lose-gravity/cat-emotion-system/enclosure/亚克力方案/工程图/back_panel.pdf

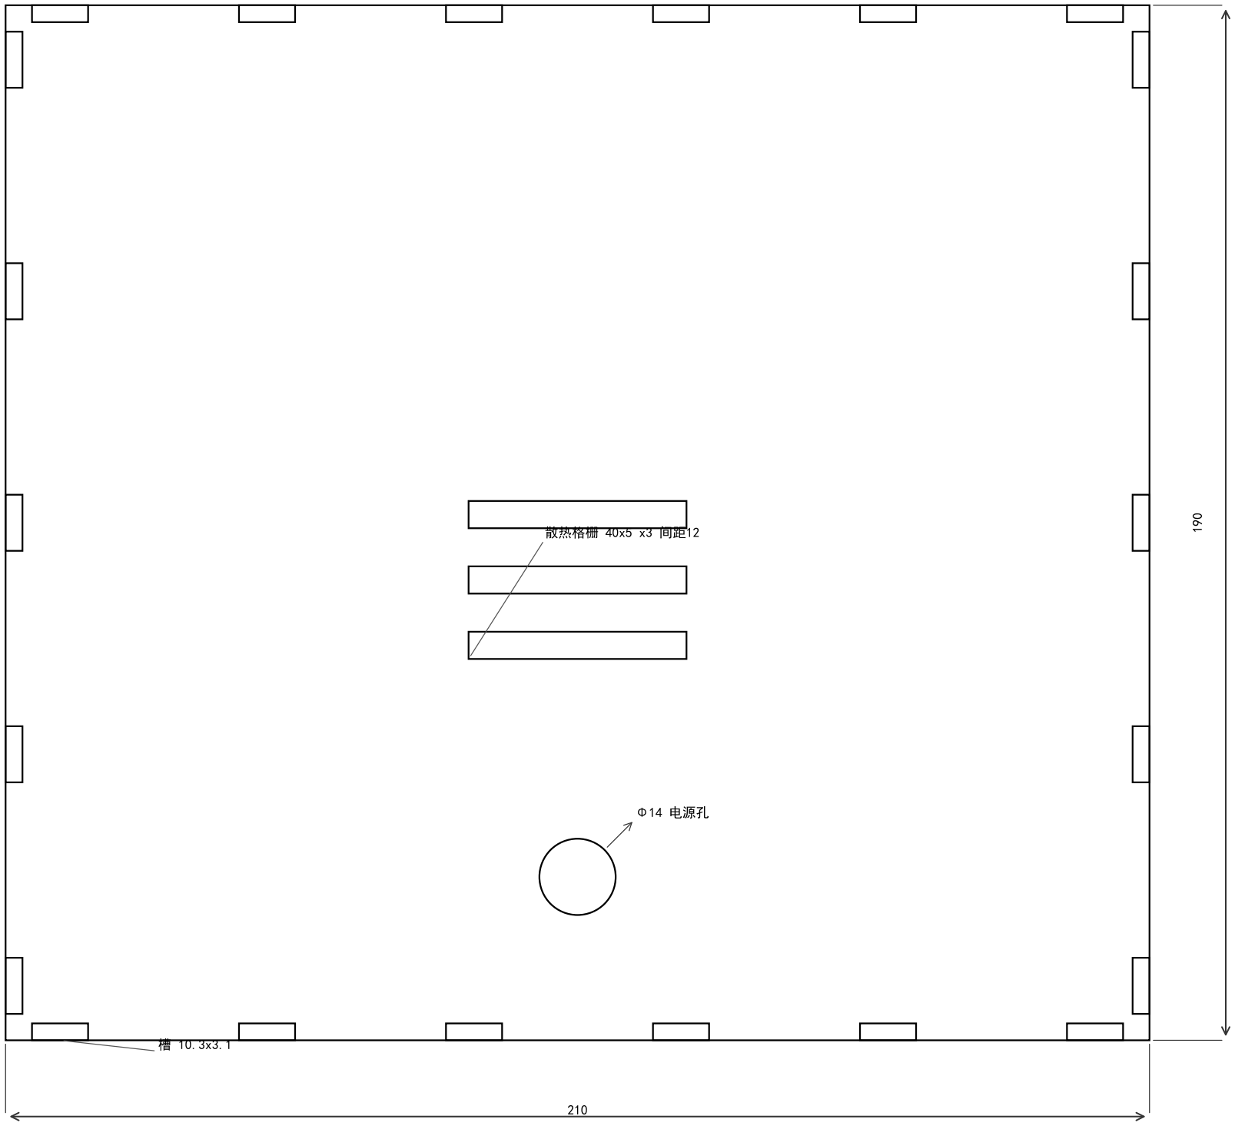
[picture p7: figure]
Φ14 电源孔; 散热格栅 40x5 x3 间距12

背板 | 白色亚克力 3mm | 1件 | 1:1 | mm
