lose-gravity/cat-emotion-system/enclosure/亚克力方案/工程图/bottom_panel.pdf

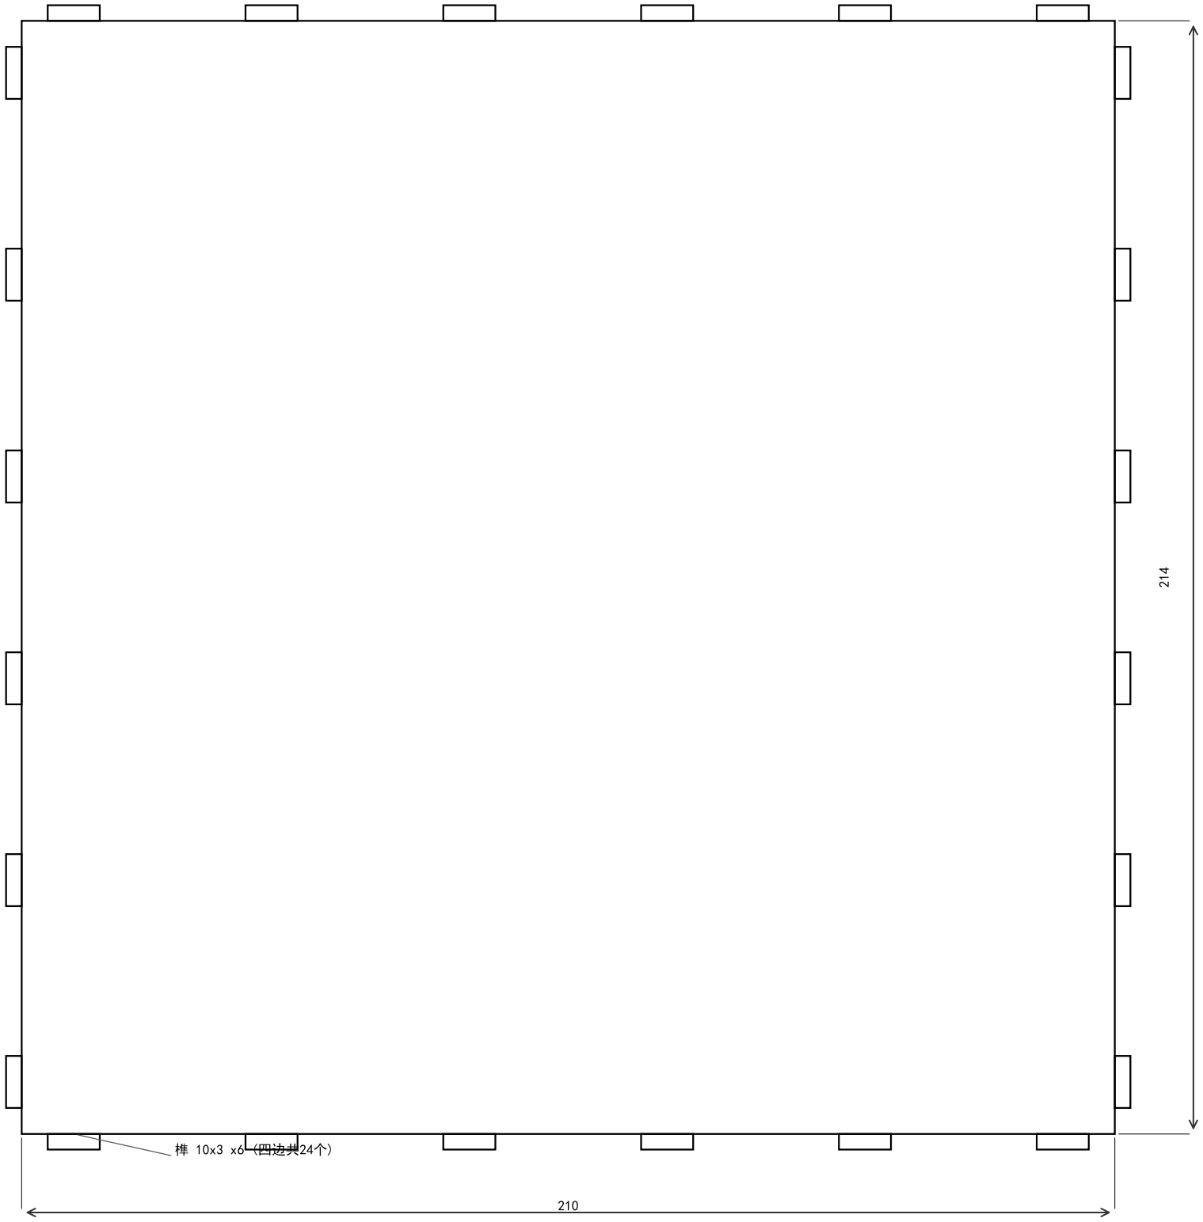
[picture p8: figure]
榫 10x3 x6 (四边共24个)

底板 | 白色亚克力 3mm | 1件 | 1:1 | mm

图面比例 1:1.1
