lose-gravity/cat-emotion-system/enclosure/亚克力方案/工程图/dispenser_vane.pdf

出粮拨片 | 白色亚克力 3mm | 1件 | 1:1 | mm

Φ5 轴孔

叶片 18x4 x3 毂Φ12
