lose-gravity/cat-emotion-system/enclosure/亚克力方案/工程图/hopper_bottom.pdf

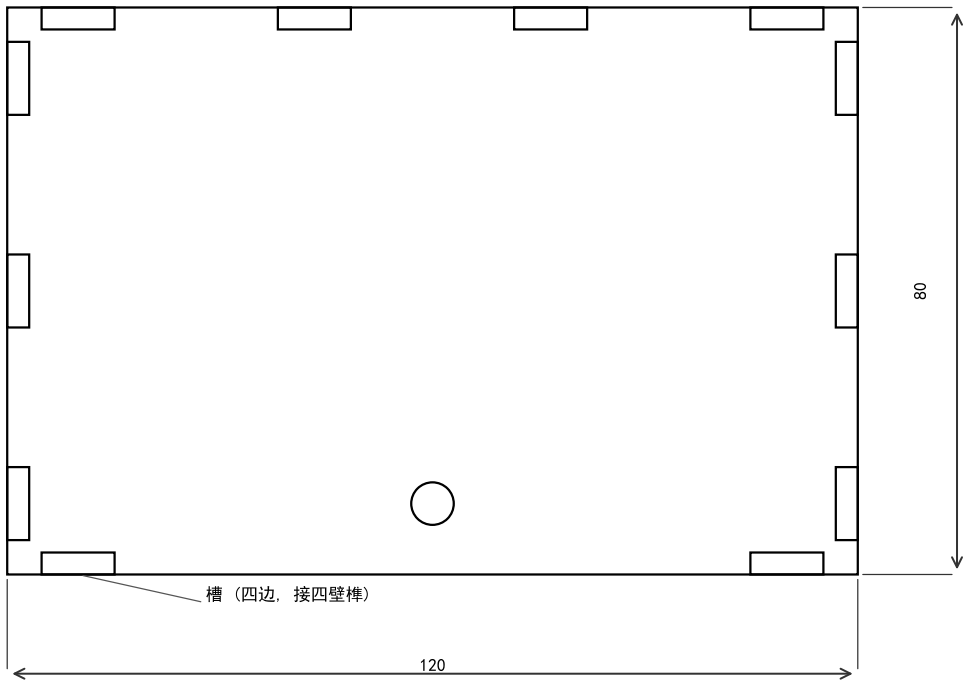
[picture p10: figure]
槽 (四边, 接四壁榫)

料仓底板 | 白色亚克力 3mm | 1件 | 1:1 | mm
