lose-gravity/cat-emotion-system/enclosure/亚克力方案/工程图/hopper_front.pdf

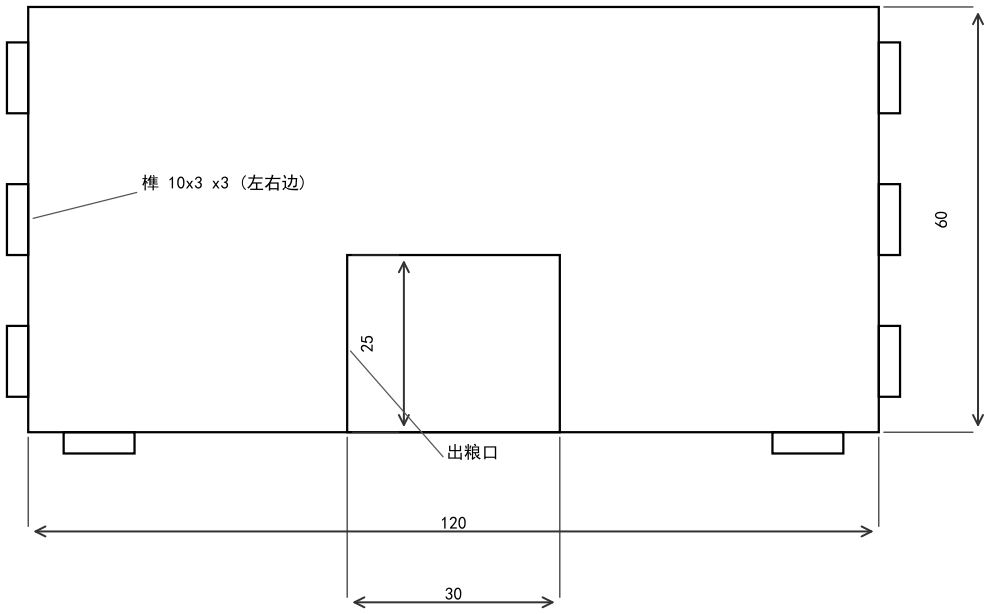
[picture p11: figure]
出粮口; 榫 10x3 x3 (左右边)

料仓前脸 | 白色亚克力 3mm | 1件 | 1:1 | mm
