lose-gravity/cat-emotion-system/enclosure/亚克力方案/工程图/hopper_left.pdf

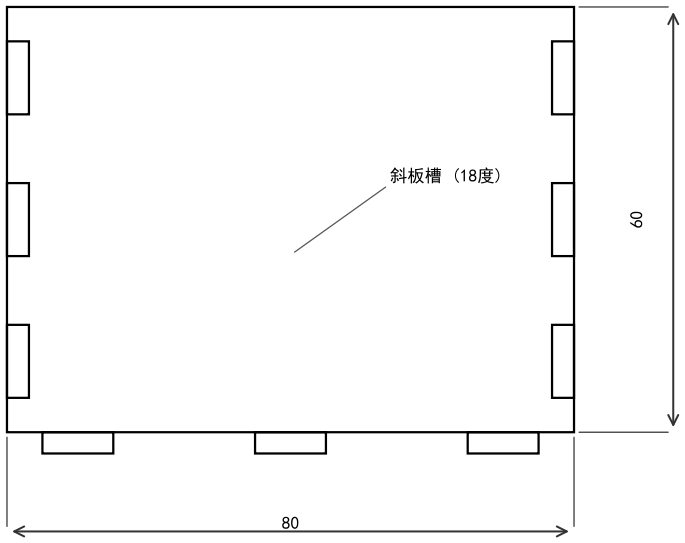
[picture p12: figure]
斜板槽 (18度)

料仓左片 | 白色亚克力 3mm | 1件 | 1:1 | mm
