lose-gravity/cat-emotion-system/enclosure/亚克力方案/工程图/hopper_right.pdf

斜板槽 (18度)

料仓右片 | 白色亚克力 3mm | 1件 | 1:1 | mm
