lose-gravity/cat-emotion-system/enclosure/亚克力方案/工程图/module_plate.pdf

元件安装板 | 白色亚克力 3mm | 1件 | 1:1 | mm

50

25

2xΦ3 功放安装孔
