lose-gravity/cat-emotion-system/enclosure/亚克力方案/工程图/servo_base.pdf

舵机座底板 | 白色亚克力 3mm | 1件 | 1:1 | mm

35

22.2

2xΦ2.5 固定孔

侧壁槽 10.3x3.1 x4
