lose-gravity/cat-emotion-system/enclosure/亚克力方案/工程图/servo_wall.pdf

舵机座侧壁 | 白色亚克力 3mm | 2件 | 1:1 | mm

35

36

2xΦ2.2 舵机夹紧孔
