lose-gravity/cat-emotion-system/enclosure/亚克力方案/工程图/side_panel.pdf

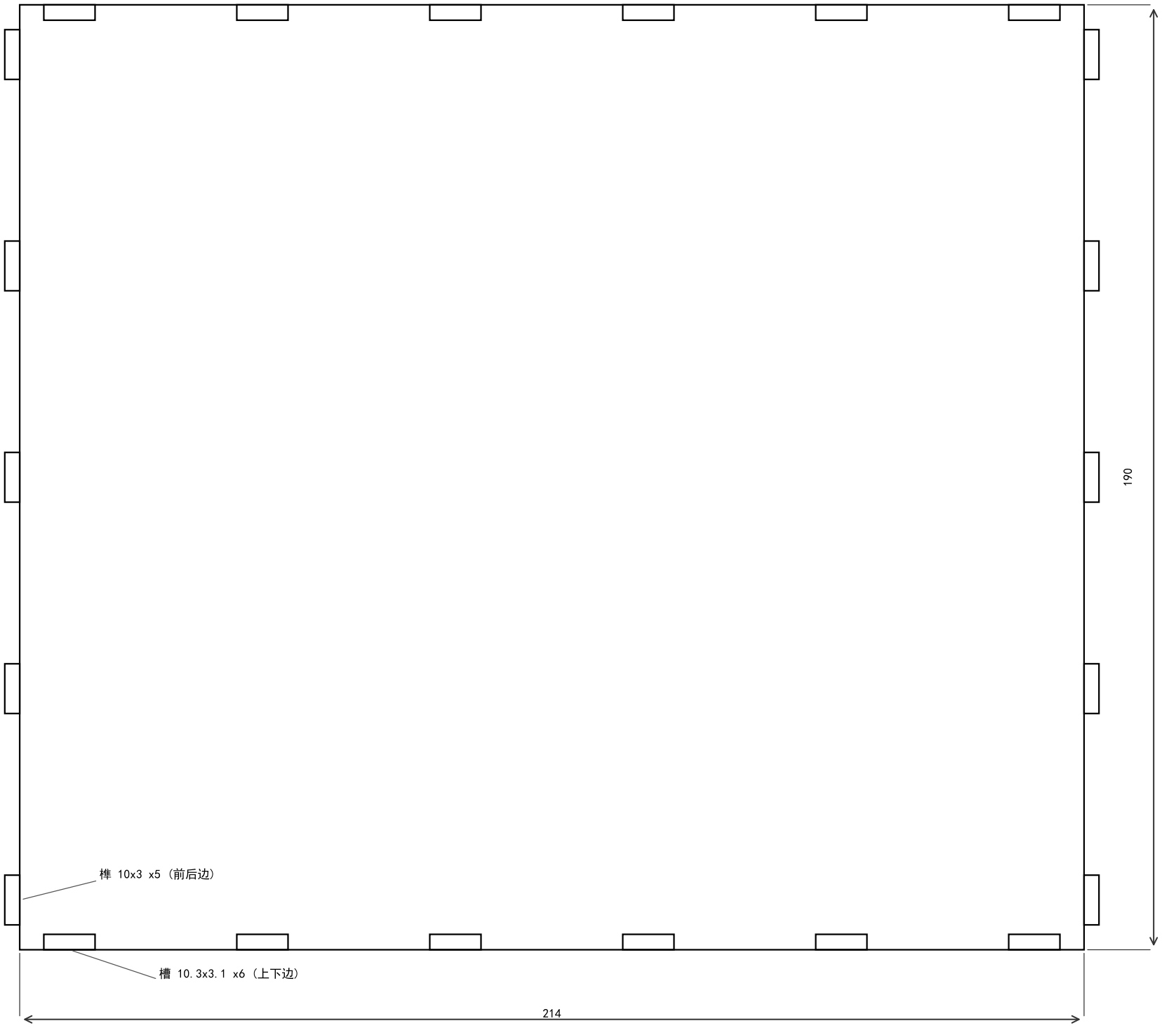
[picture p13: figure]
榫 10x3 x5 (前后边); 槽 10.3x3.1 x6 (上下边)

侧板 | 白色亚克力 3mm | 2件 | 1:1 | mm
