lose-gravity/cat-emotion-system/enclosure/亚克力方案/工程图/top_panel.pdf

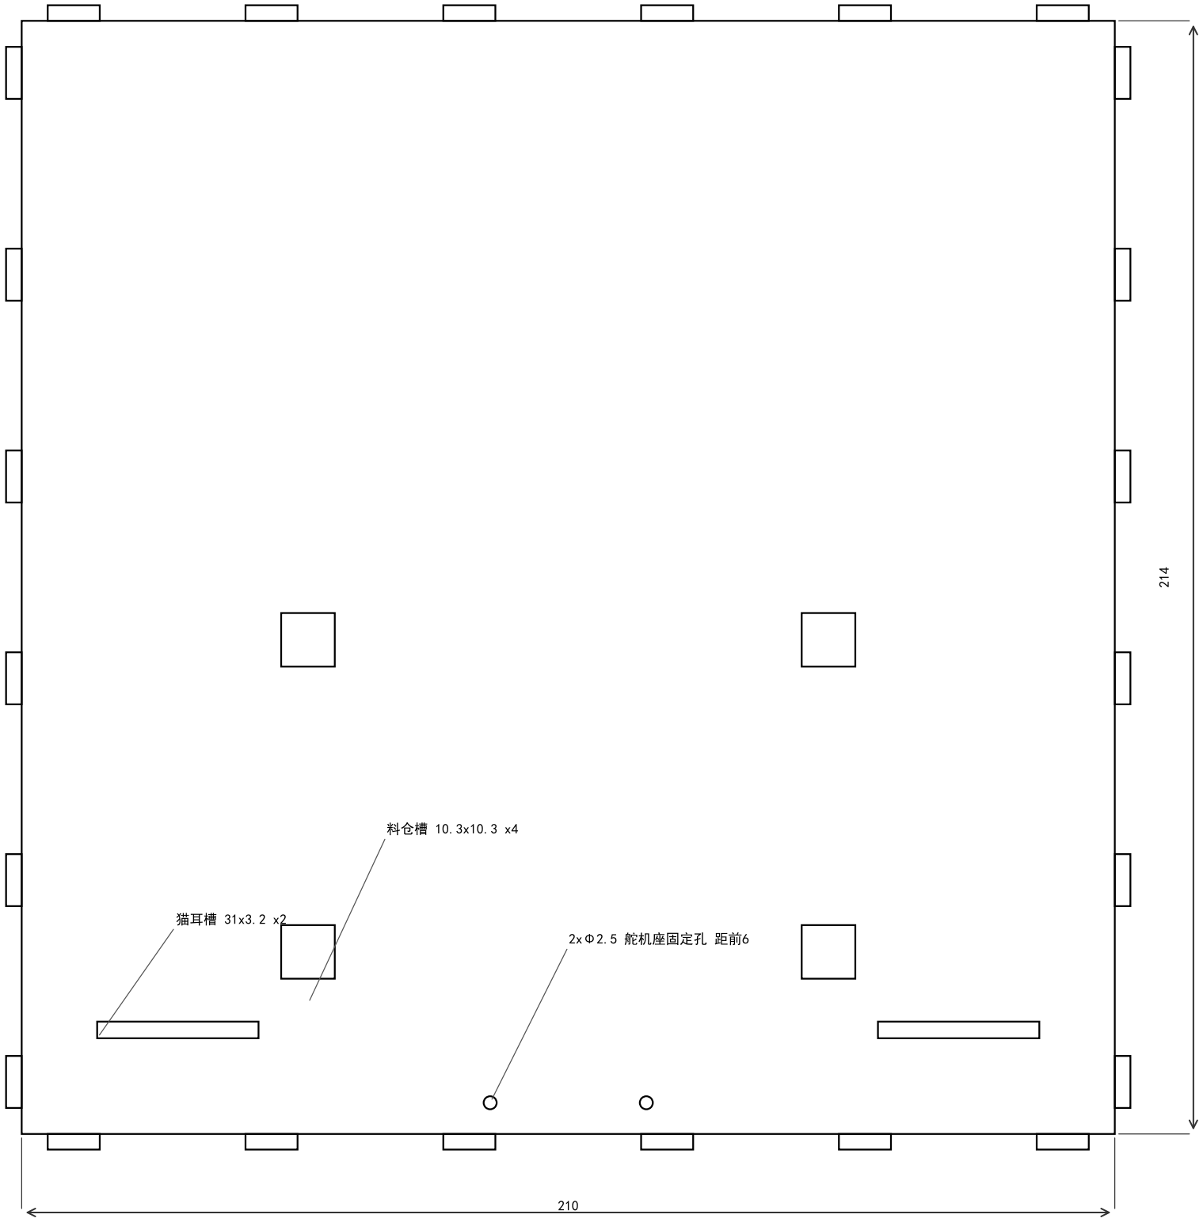
[picture p14: figure]
2xΦ2.5 舵机座固定孔 距前6; 猫耳槽 31x3.2 x2; 料仓槽 10.3x10.3 x4

顶板 | 白色亚克力 3mm | 1件 | 1:1 | mm

图面比例 1:1.1
