lose-gravity/cat-emotion-system/training/改进算法/改进报告.md

# 猫情绪识别算法改进报告（2026-10-20）

算法岗代码在本机（librosa 1.0.0 + sklearn 1.9）全流程复现后，发现并修复了三个问题，并产出了一套 HLS 友好的新交付物。原模型文件未动，本目录（04-改进算法/）全部为新增。

## 一、发现的问题

### 1. 数据泄露导致指标虚高
原训练脚本（[训练脚本.py](../01-训练代码/训练脚本.py)）**先对饥饿类做数据增强、再划分训练/测试集**——增强变体会同时出现在两边。且原验证脚本对全量 440 段评估时，饥饿类原始文件全部在训练集里。本机复现结果：

| 评估方式 | 数字 |
|---|---|
| 原版"全量440段自评" | 90.23%（与队友声明 90.2% 完全一致，复现成功） |
| **修正后 5 折交叉验证（真实泛化）** | **65.7%** |

90.2% 是训练集上的自评数字，答辩被问评估协议会出问题。修正后的协议：**GroupKFold 按源文件分组、先划分后增强、测试折只用原始文件**。

### 2. 部署链路在 PYNQ-Z1 上走不通
原交付依赖 `librosa + onnxruntime`，但 PYNQ-Z1（Zynq-7020，32 位 ARM）没有 onnxruntime 的 armhf 预编译包，librosa 在板上也过重。且 ONNX 是 opset 21，老版推理引擎加载不了。

### 3. 特征参数大量依赖 librosa 隐式默认值
rms/zcr/谱质心的帧移（512）与 MFCC（160）不一致、n_fft=2048、centroid 用幅度谱而 MFCC 用功率谱、delta 是 Savitzky-Golay 滤波……全部隐式。已全部钉死并生成矩阵文件，见 [特征规格.md](特征规格.md)。

## 二、新方案的实测数字（协议一致，可复现）

### 模型对比（5 折 GroupKFold，固定 1.5s 窗口管线）

| 方案 | CV | 亲昵 | 饥饿 | 焦虑 | HLS 可行性 |
|---|---|---|---|---|---|
| MLP(512,256) 基线 | 65.7% | 39% | 71% | 79% | ✓ |
| MLP+平衡权重 | 68.2% | 52% | 53% | 84% | ✓ |
| MLP+885维分段特征 | 68.4% | 58% | 52% | 81% | ✓ |
| **2×MLP 概率平均集成（最终）** | **71.4%** | 51% | 65% | 86% | ✓（2 个小模型） |
| 随机森林（参考上限） | 73.0% | 52% | 62% | 90% | ✗ |
| XGBoost（参考上限） | 71.1% | 41% | 78% | 86% | ✗ |

**固定 1.5s 窗口 vs 原版变长裁剪：65.7% vs 65.7%，零代价**——HLS 可以放心按固定窗口实现。

### 最终集成模型阈值表（OOF，440 原始样本）

| 阈值 | 饥饿 检出/误触 | 焦虑 检出/误触 |
|---|---|---|
| 0.4 | 66.3% / 16.1% | 87.3% / 22.8% |
| **0.5** | **54.3% / 11.5%** | **84.2% / 16.0%** |
| **0.6** | 44.6% / 6.3% | **78.7% / 11.4%** |
| 0.7 | 35.9% / 3.7% | 71.9% / 8.7% |

推荐：饥饿 0.5 + 连续 2 段确认（误触降至 ~1.3%），焦虑 0.6。真实场景猫连续叫几秒会产生多段窗口，累计检出率远高于单段数字。

### 量化（per-tensor 对称，已修复模拟 bug 后）

| 方案 | 精度损失 |
|---|---|
| int8 全量化（权重+激活） | **0.23pp** |
| int16 全量化（DSP48 原生） | 0.00pp |
| int8 仅权重 | 0.00pp |

BRAM 里 int8 权重 277KB×2 模型，Zynq-7020 的 630KB 放得下（或 DDR 流式读）。

## 三、新交付物清单（04-改进算法/）

**HLS 队友用：**
- [特征规格.md](特征规格.md) —— 全部参数显式化的实现依据
- mel_128x1025.csv / dct_40x128.csv / hann_400.csv / hann_2048.csv / savgol_d1(2).csv / savgol_d1(2)_51.csv —— 固定矩阵
- weights_float_final/、weights_int8_final/ —— 两个模型的权重+scaler+量化尺度
- golden/ —— 40 段对拍数据（pcm + features295 + features885 + probs + manifest）
- final_meta.json —— 阈值表/结构/指标

**算法侧复用：**
- features_numpy.py —— 板端纯 numpy 特征（与 librosa 对拍 451 组误差 <1e-3）
- mlp_numpy.py —— 板端推理（float/int8）
- 00_生成矩阵.py ~ 09_最终模型.py —— 全流程可重跑
- cat_dataset/ —— 数据集（Zenodo 4008297 原始 440 段，按三类分好）

## 四、答辩口径建议

- "数据增强在划分后做、按猫分组交叉验证" —— 评估协议严谨，经得起问
- "固定 1.5s 窗口与变长裁剪精度相同" —— 为硬件实现做的工程决策有数据支撑
- "int8 量化损失 0.23pp，模型 28 万参数" —— 部署优化有量化数据
- 准确率数字用 **71.4%（5 折交叉验证）**，阈值表、每类召回见 final_meta.json
- 原 90.2% 不要再用（是训练集自评）；若被问差异，答"原数字未按源文件分组划分，存在增强数据跨训练/测试集的泄露"

## 五、可选后续（非必须）

1. 增加声学特征（基频轨迹 pyin、谱平坦度、调制谱）——原论文用调制谱+DAG-HMM 达 95.9%，说明特征还有空间
2. QAT（量化感知训练）——目前 int8 已够用，不必
3. extras.zip 里的"其他叫声"可做第四个"无动作"类——降低误触发
