lose-gravity/cat-emotion-system/docs/接线图.png

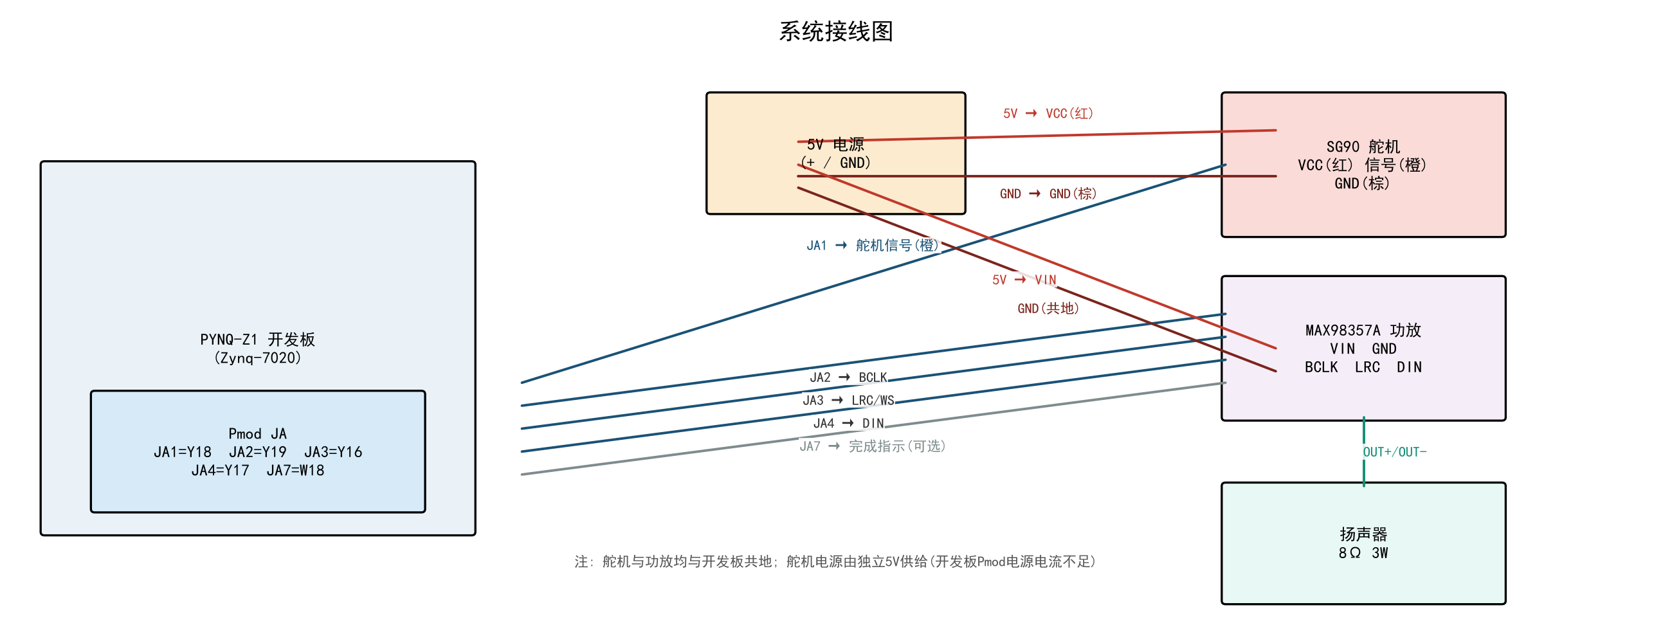
docs/接线图.png
