lose-gravity/cat-emotion-system/enclosure/亚克力方案/3D效果图/料仓效果图-侧视.png

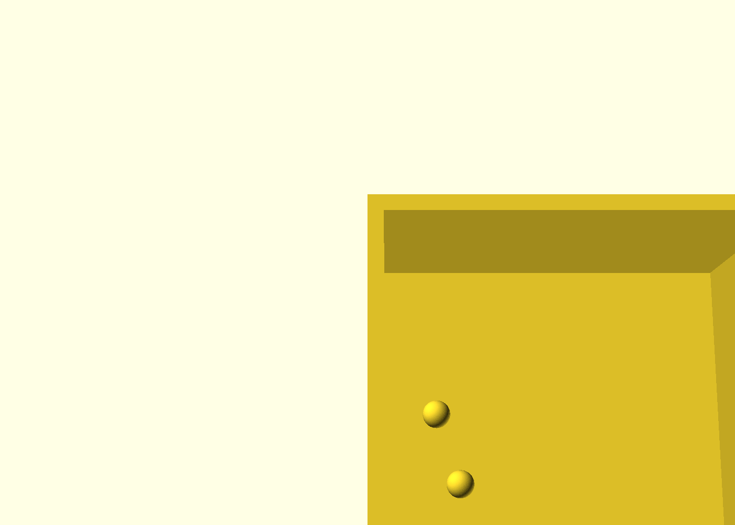
enclosure/亚克力方案/3D效果图/料仓效果图-侧视.png
