lose-gravity/cat-emotion-system/enclosure/亚克力方案/工程图/back_panel.jpg

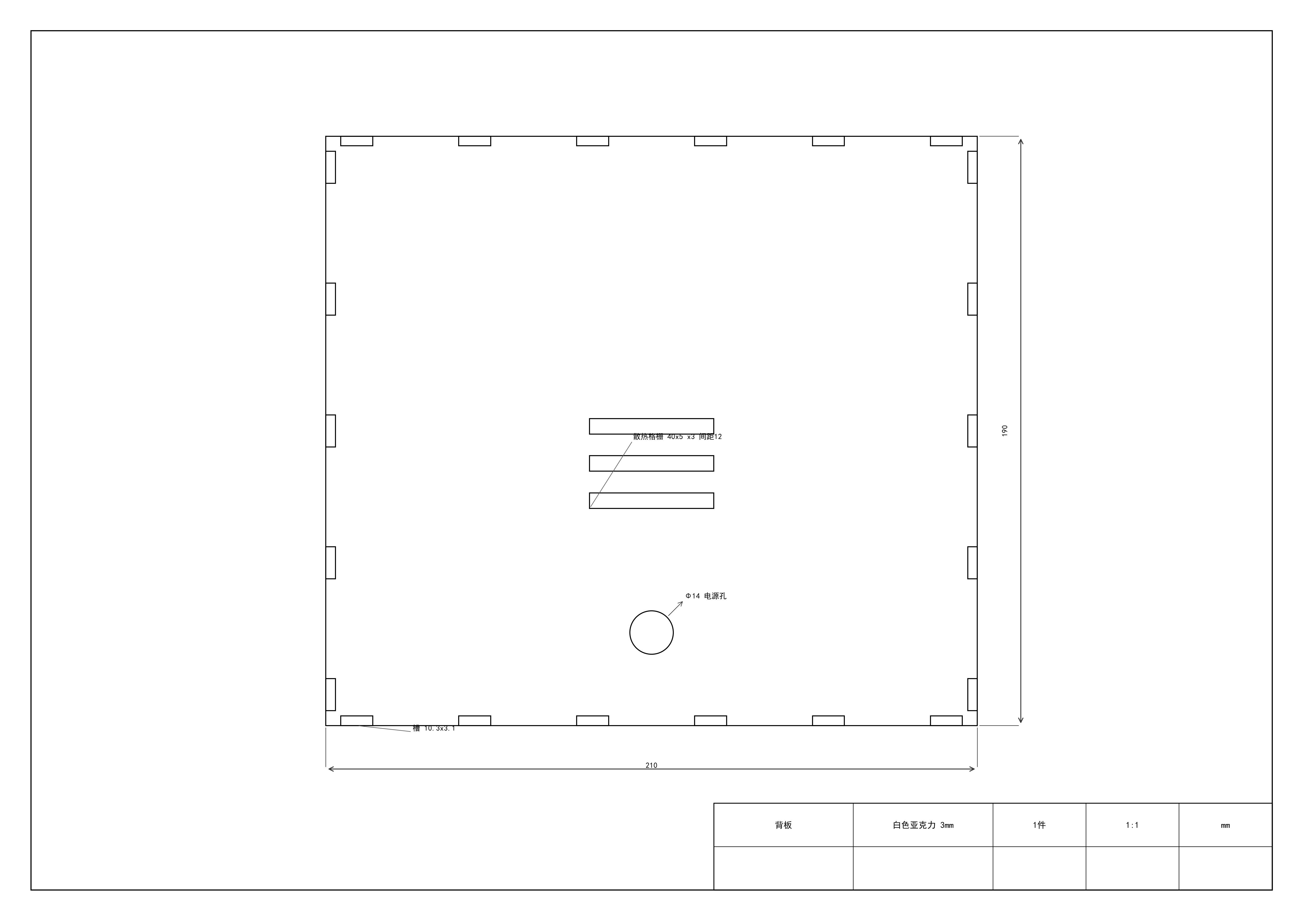
enclosure/亚克力方案/工程图/back_panel.jpg
