lose-gravity/cat-emotion-system/enclosure/亚克力方案/工程图/board_locator.jpg

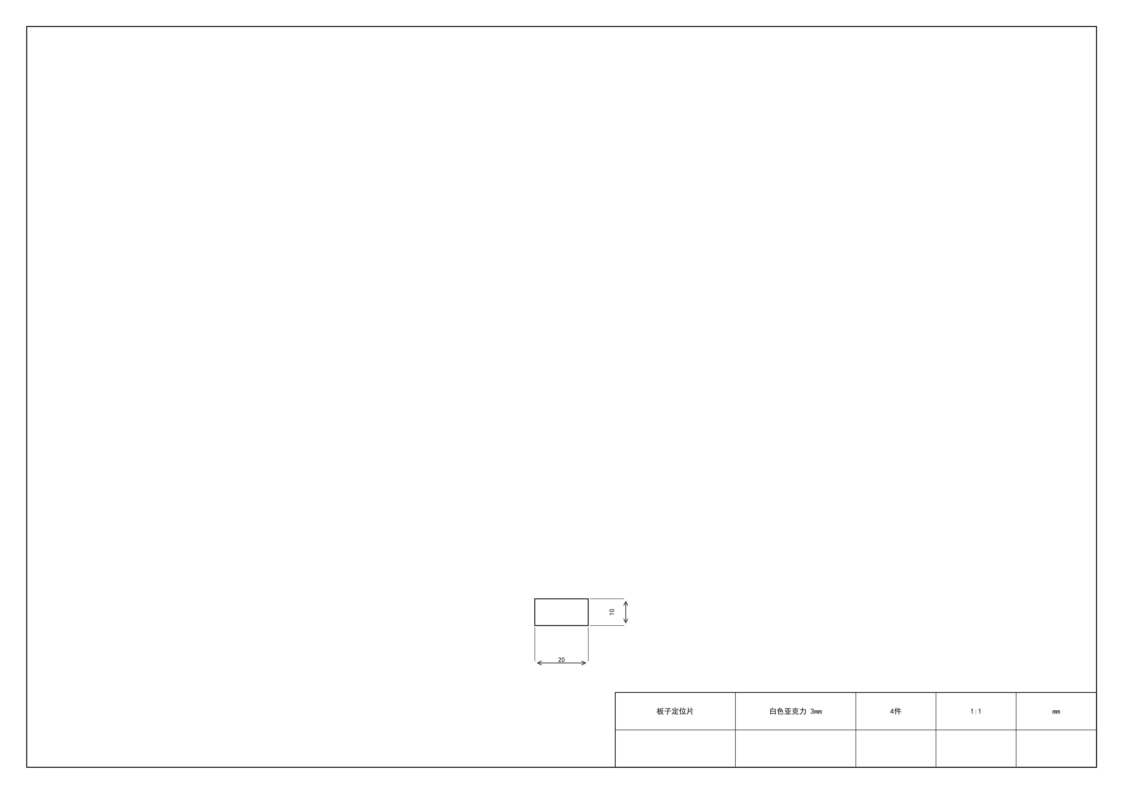
enclosure/亚克力方案/工程图/board_locator.jpg
