lose-gravity/cat-emotion-system/enclosure/亚克力方案/工程图/cat_ear.jpg

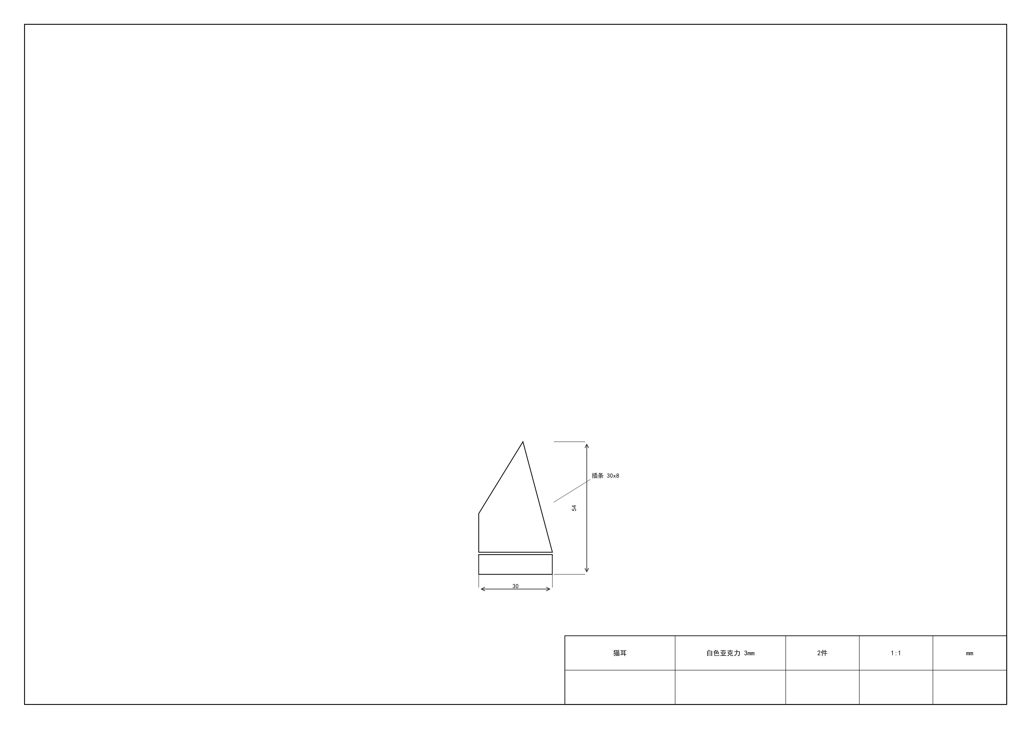
enclosure/亚克力方案/工程图/cat_ear.jpg
