lose-gravity/cat-emotion-system/enclosure/亚克力方案/工程图/hopper_back.jpg

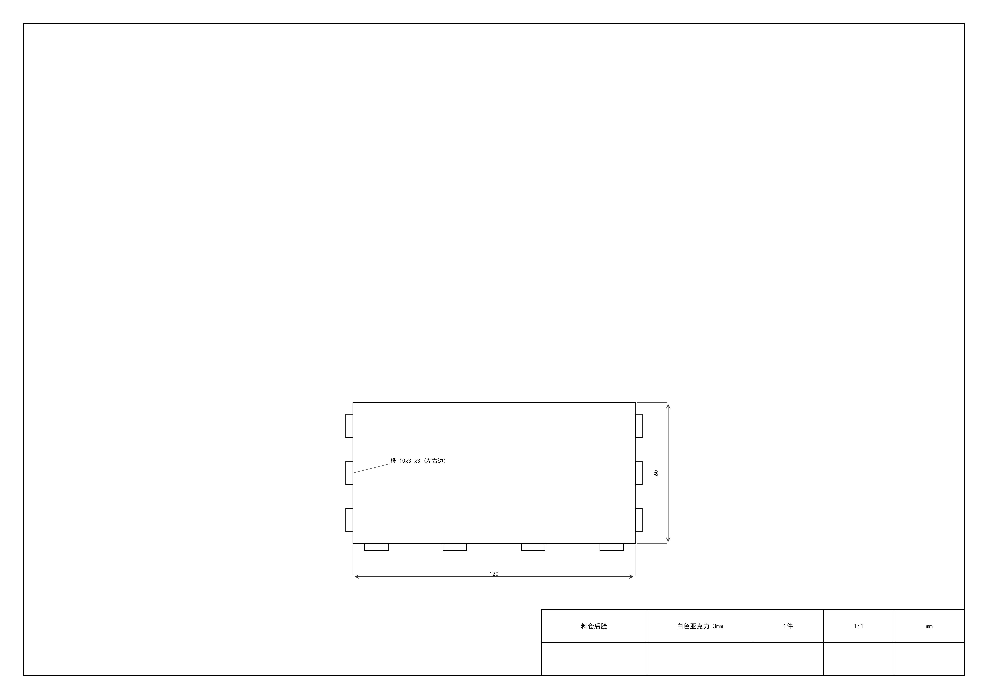
enclosure/亚克力方案/工程图/hopper_back.jpg
