lose-gravity/cat-emotion-system/enclosure/亚克力方案/laser/front_panel.dxf

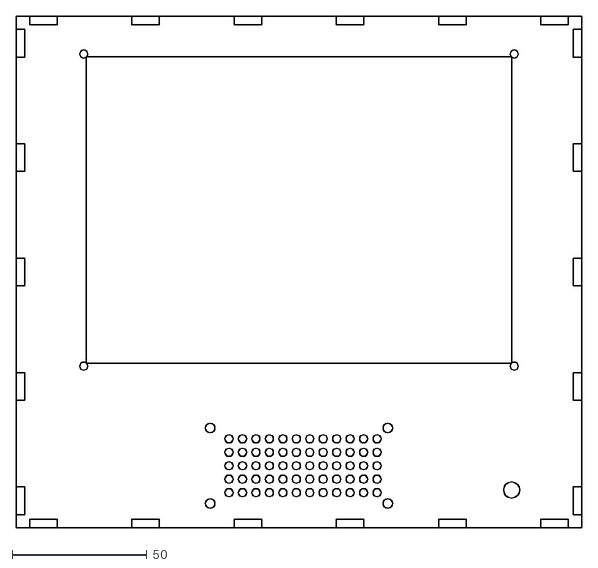
[picture p28: CAD file, 2026-11-04]
enclosure/亚克力方案/laser/front_panel.dxf
210.0 x 190.0
