lose-gravity/cat-emotion-system/enclosure/亚克力方案/laser/hopper_left.dxf

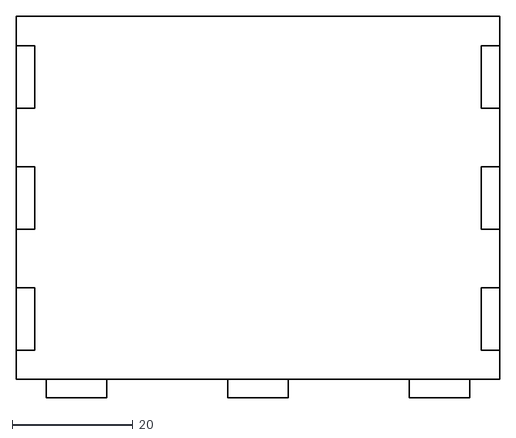
[picture p29: CAD file, 2026-11-04]
enclosure/亚克力方案/laser/hopper_left.dxf
80.0 x 63.0
