lose-gravity/cat-emotion-system/enclosure/亚克力方案/laser/servo_base.dxf

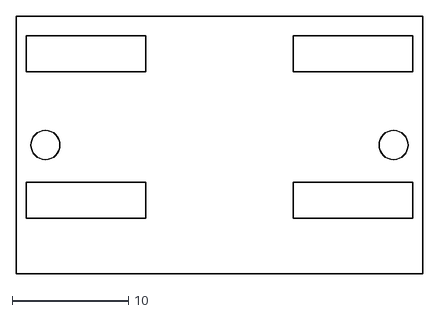
[picture p30: CAD file, 2026-11-04]
enclosure/亚克力方案/laser/servo_base.dxf
35.0 x 22.2
