lose-gravity/cat-emotion-system/enclosure/亚克力方案/laser/module_plate.dxf

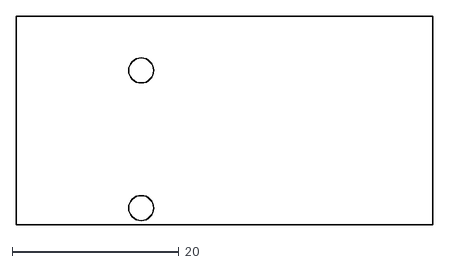
[picture p31: CAD file, 2026-11-04]
enclosure/亚克力方案/laser/module_plate.dxf
50.0 x 25.0
