lose-gravity/cat-emotion-system/enclosure/亚克力方案/laser/top_panel.dxf

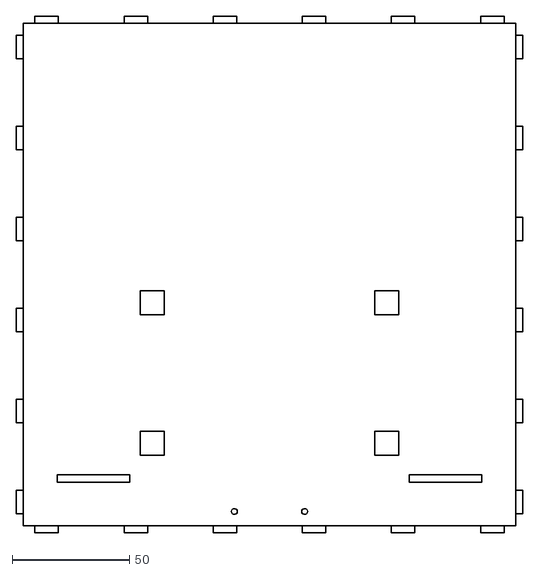
[picture p32: CAD file, 2026-11-04]
enclosure/亚克力方案/laser/top_panel.dxf
216.0 x 220.0
