lose-gravity/cat-emotion-system/enclosure/亚克力方案/laser/bottom_panel.dxf

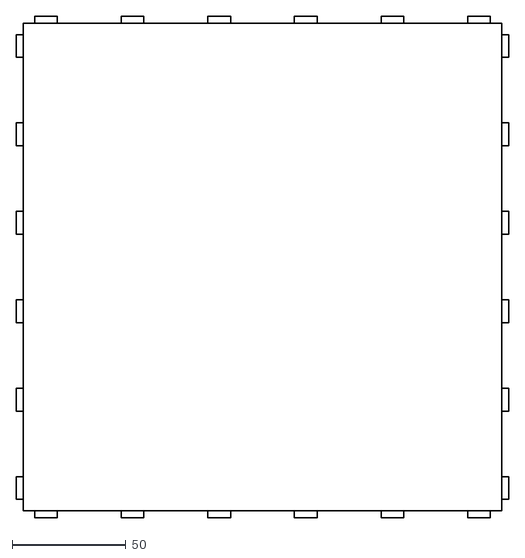
[picture p33: CAD file, 2026-11-04]
enclosure/亚克力方案/laser/bottom_panel.dxf
216.0 x 220.0
