lose-gravity/cat-emotion-system/enclosure/亚克力方案/laser/board_locator.dxf

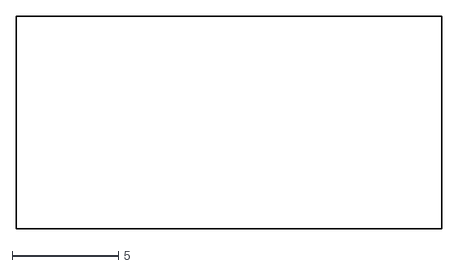
[picture p34: CAD file, 2026-11-04]
enclosure/亚克力方案/laser/board_locator.dxf
20.0 x 10.0
