lose-gravity/cat-emotion-system/enclosure/亚克力方案/laser/hopper_right.dxf

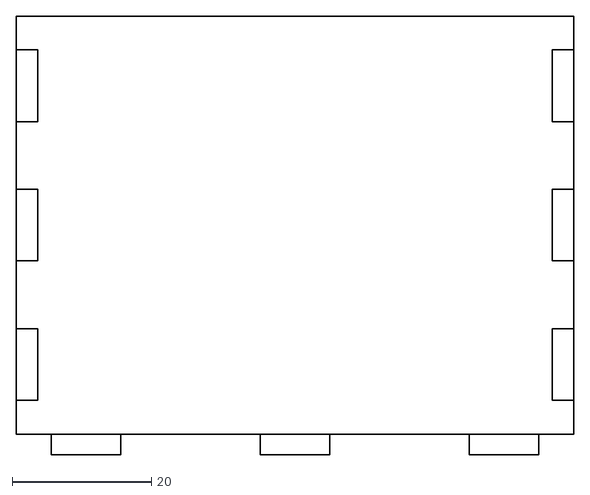
[picture p35: CAD file, 2026-11-04]
enclosure/亚克力方案/laser/hopper_right.dxf
80.0 x 63.0
