lose-gravity/cat-emotion-system/enclosure/亚克力方案/laser/hopper_front.dxf

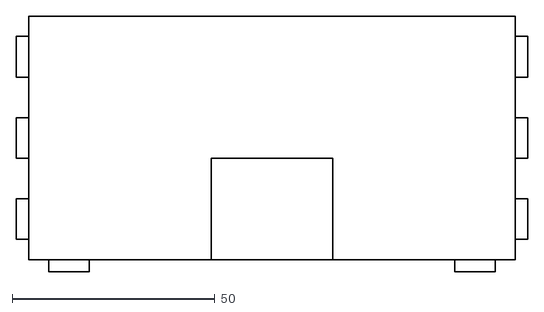
[picture p36: CAD file, 2026-11-04]
enclosure/亚克力方案/laser/hopper_front.dxf
126.0 x 63.0
