lose-gravity/cat-emotion-system/enclosure/亚克力方案/laser/hopper_bottom.dxf

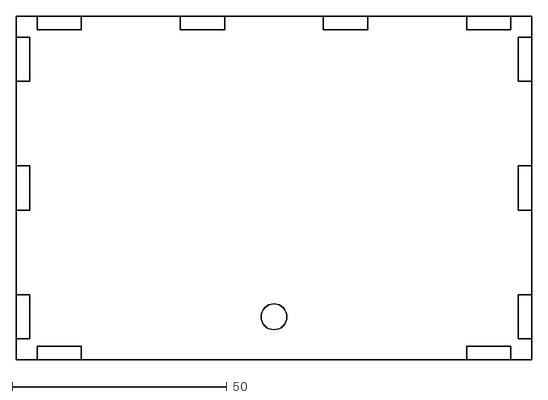
[picture p37: CAD file, 2026-11-04]
enclosure/亚克力方案/laser/hopper_bottom.dxf
120.0 x 80.0
