lose-gravity/cat-emotion-system/enclosure/亚克力方案/laser/side_panel.dxf

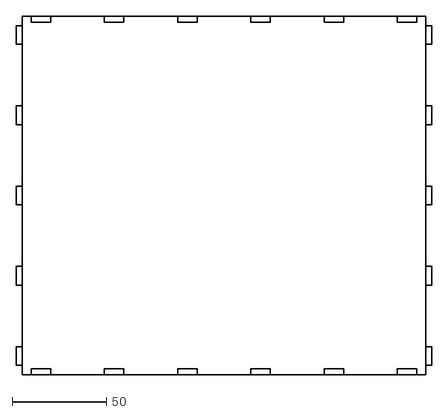
[picture p38: CAD file, 2026-11-04]
enclosure/亚克力方案/laser/side_panel.dxf
220.0 x 190.0
