lose-gravity/cat-emotion-system/enclosure/亚克力方案/laser/servo_wall.dxf

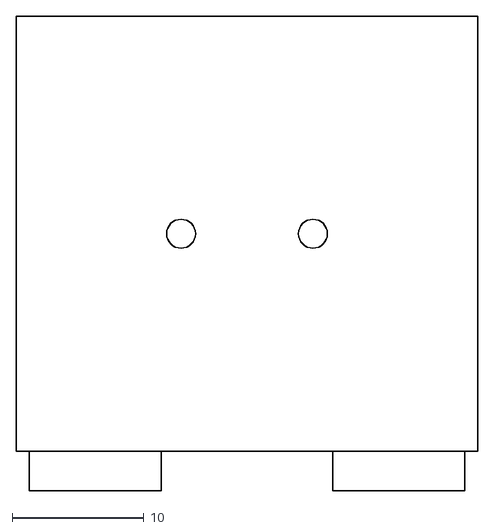
[picture p39: CAD file, 2026-11-04]
enclosure/亚克力方案/laser/servo_wall.dxf
35.0 x 36.0
