lose-gravity/cat-emotion-system/enclosure/亚克力方案/laser/dispenser_vane.dxf

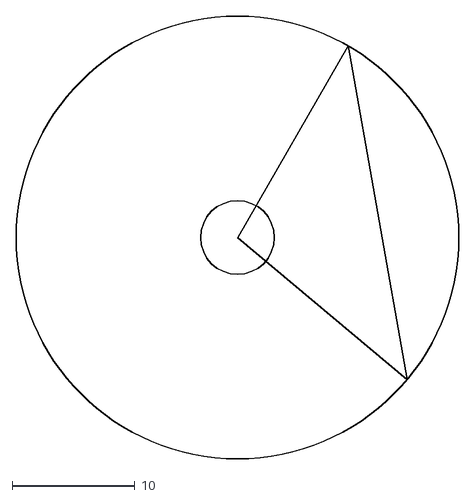
[picture p40: CAD file, 2026-11-04]
enclosure/亚克力方案/laser/dispenser_vane.dxf
36.0 x 36.0
