lose-gravity/cat-emotion-system/enclosure/亚克力方案/laser/hopper_back.dxf

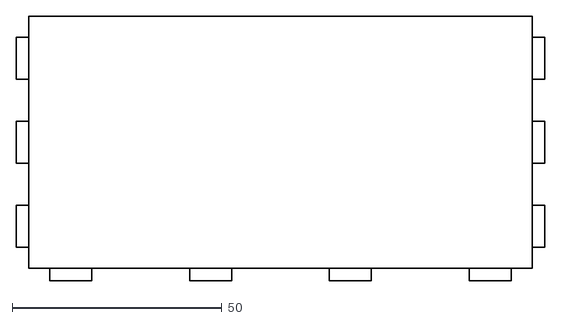
[picture p41: CAD file, 2026-11-04]
enclosure/亚克力方案/laser/hopper_back.dxf
126.0 x 63.0
