lose-gravity/cat-emotion-system/enclosure/亚克力方案/laser/cat_ear.dxf

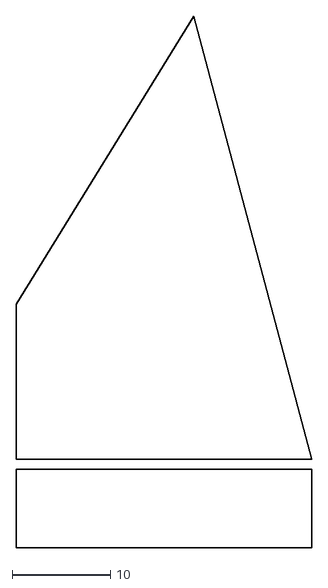
[picture p42: CAD file, 2026-11-04]
enclosure/亚克力方案/laser/cat_ear.dxf
30.0 x 54.0
