lose-gravity/cat-emotion-system/enclosure/亚克力方案/组装说明-激光版.txt

亚克力外壳 组装说明(激光切割版)
================================
材料: 白色亚克力3mm, 榫卯插槽结构, 主体无需螺丝

一、到货检查(10分钟)
1. 数件数: 共23件(见zip内数量清单)
2. 抽检: 前面板屏幕窗158x114, 用尺量
3. 试插: 拿一块侧板的榫试插前面板的槽, 顺滑即可(紧了用砂纸磨榫, 松了垫胶)

二、拼装顺序
第1步 拼箱体(5分钟, 不粘)
  底板平放 -> 前后板插槽卡入底板榫 -> 左右侧板卡入前后板
  -> 顶板最后盖上(顶板榫插进四周板的槽)
第2步 前面板装元件(拼箱前做更顺手)
  屏幕: 4颗M3螺丝+螺母(前面板3mm孔位)
  喇叭: 4颗M3螺丝+螺母(3.5mm孔位)
  麦克风: 对准6mm孔, 双面胶贴内侧
  功放: 拧在元件安装板(2个3mm孔), 小板放喇叭旁
第3步 底板装板子
  4片定位片用亚克力胶/双面胶粘在底板(板子122x87四角位置)
  PYNQ-Z1放定位片之间, 双面胶加固; 面包板贴右侧
第4步 顶部
  料仓: 前后左右底5片插槽拼成平底盒, 出粮口朝前
  料仓放顶板料仓槽位置, 点胶固定
  舵机座: 底板+2侧壁插槽拼装, 用M2.5螺丝固定在顶板前边沿2孔(轴竖直朝上)
  舵机轴从料仓底板的Φ6孔穿进料仓
  拨片(缺口圆盘式,Φ36)平放在料仓底板上, Φ6孔套住舵机轴
  粮堆在底板上贴着出粮口: 舵机转到缺口时粮被推进出粮口漏下
  (演示时粮不用多, 一撮贴着出粮口放即可; 轴短可垫舵机臂)
  猫耳插顶板猫耳槽
第5步 电源线
  电源线插头从背板14mm孔穿入, 插板子电源口(JP5在REG侧, 开关ON)

三、易损提示
- 亚克力脆, 插槽对不准别硬掰, 对准了轻轻按
- 搬运时托底板, 别抓猫耳/料仓
- 白色亚克力表面容易留指纹, 组装后擦一遍再上镜

四、重要提醒
1. 亚克力榫头(10x3mm)较脆: 拼装一次到位, 对不准轻轻晃动, 禁止硬掰,
   反复拆装容易崩角; 拼好后不拆
2. 前面板屏幕窗开口大: 取件时平托, 运输时垫硬纸板, 防止中间压断
3. 槽宽10.3mm已含割缝余量: 店家割缝若>0.2mm, 拼装会偏松, 可用亚克力胶点胶加固
4. 料仓斜板18度: 装好后放几粒粮试滑, 若不下滑说明粮太涩, 垫高料仓后侧即可
