lose-gravity/cat-emotion-system/enclosure/亚克力方案/工程图/front_panel.pdf

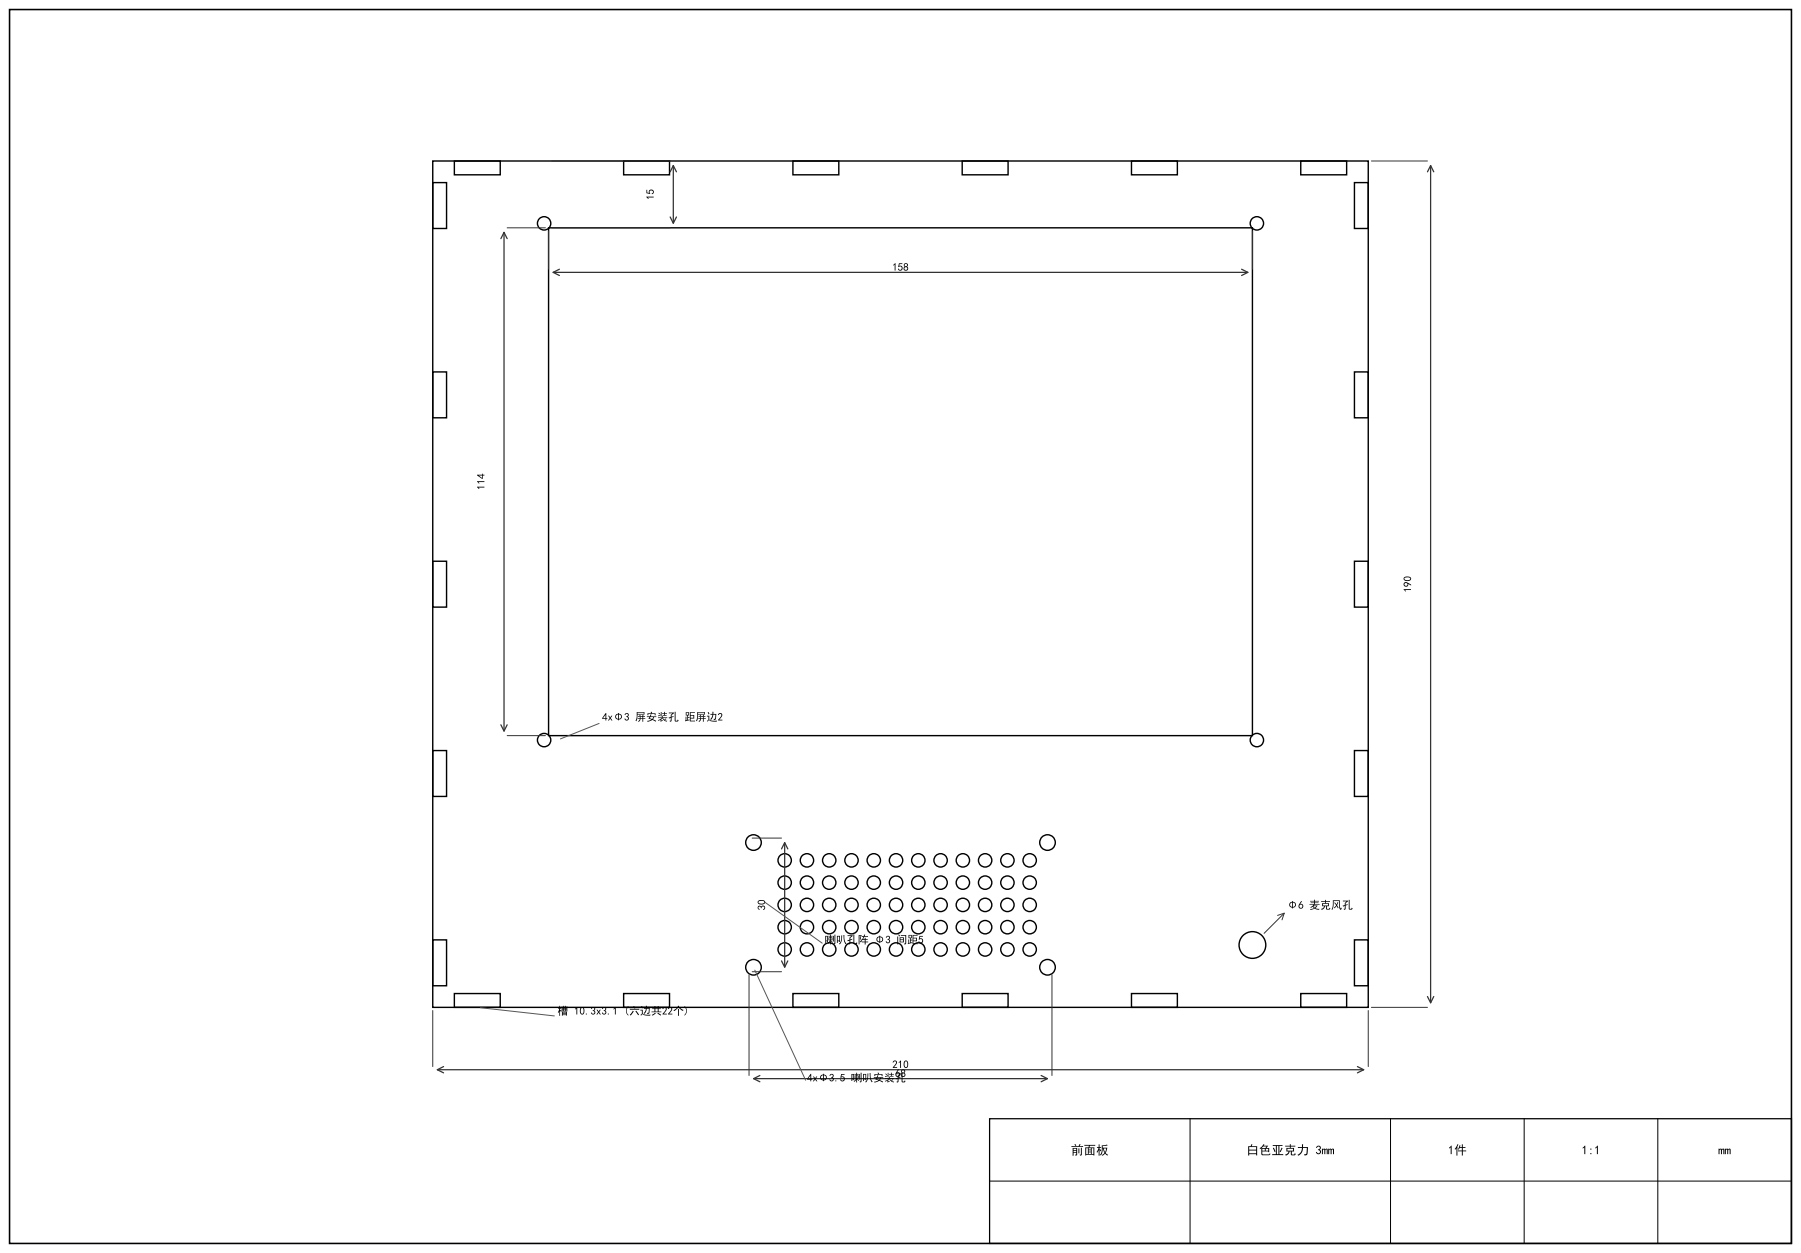
[picture p43: page 1]
前面板; 白色亚克力 3mm; 4xΦ3 屏安装孔 距屏边2; 喇叭孔阵 Φ3 间距5; 4xΦ3.5 喇叭安装孔; Φ6 麦克风孔; 槽 10.3x3.1 (六边共22个)
